Gustavomurta/EPM7032_CPLD/Images/IMG_20251213_151516328.jpg

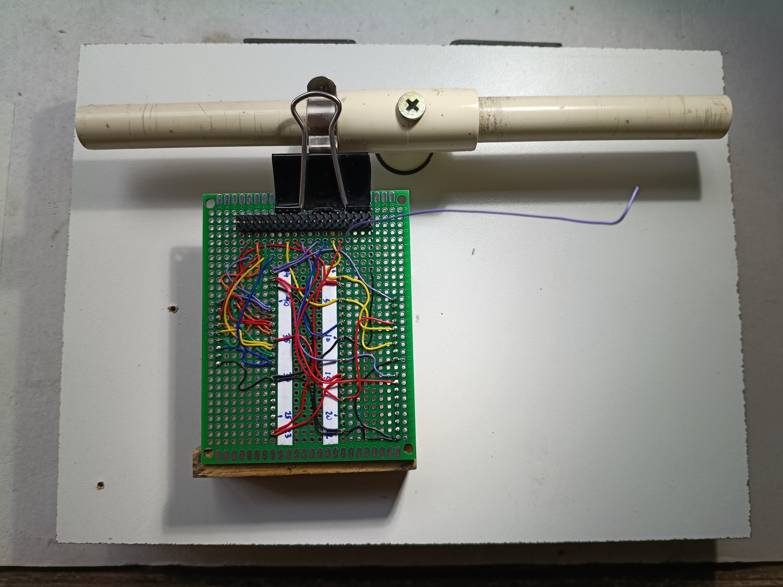
Images/IMG_20251213_151516328.jpg
