Gustavomurta/EPM7032_CPLD/Images/IMG_20251213_151541355.jpg

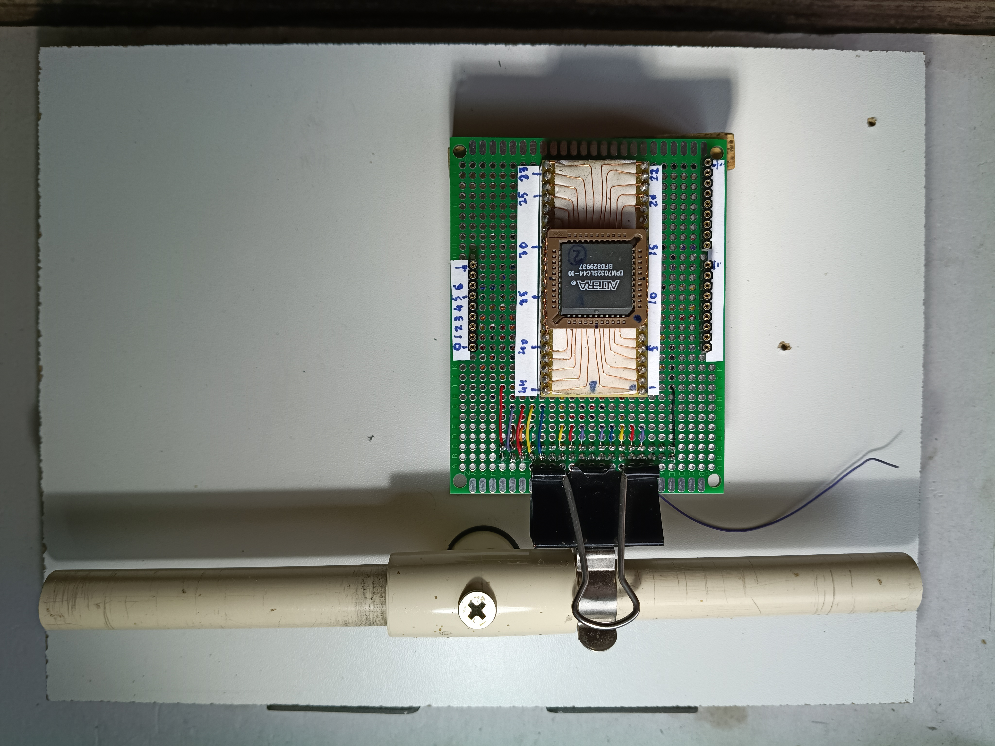
Images/IMG_20251213_151541355.jpg
