Gustavomurta/EPM7032_CPLD/hardware/EPM7032S ISP PROGRAMMER Gustavo .JPG

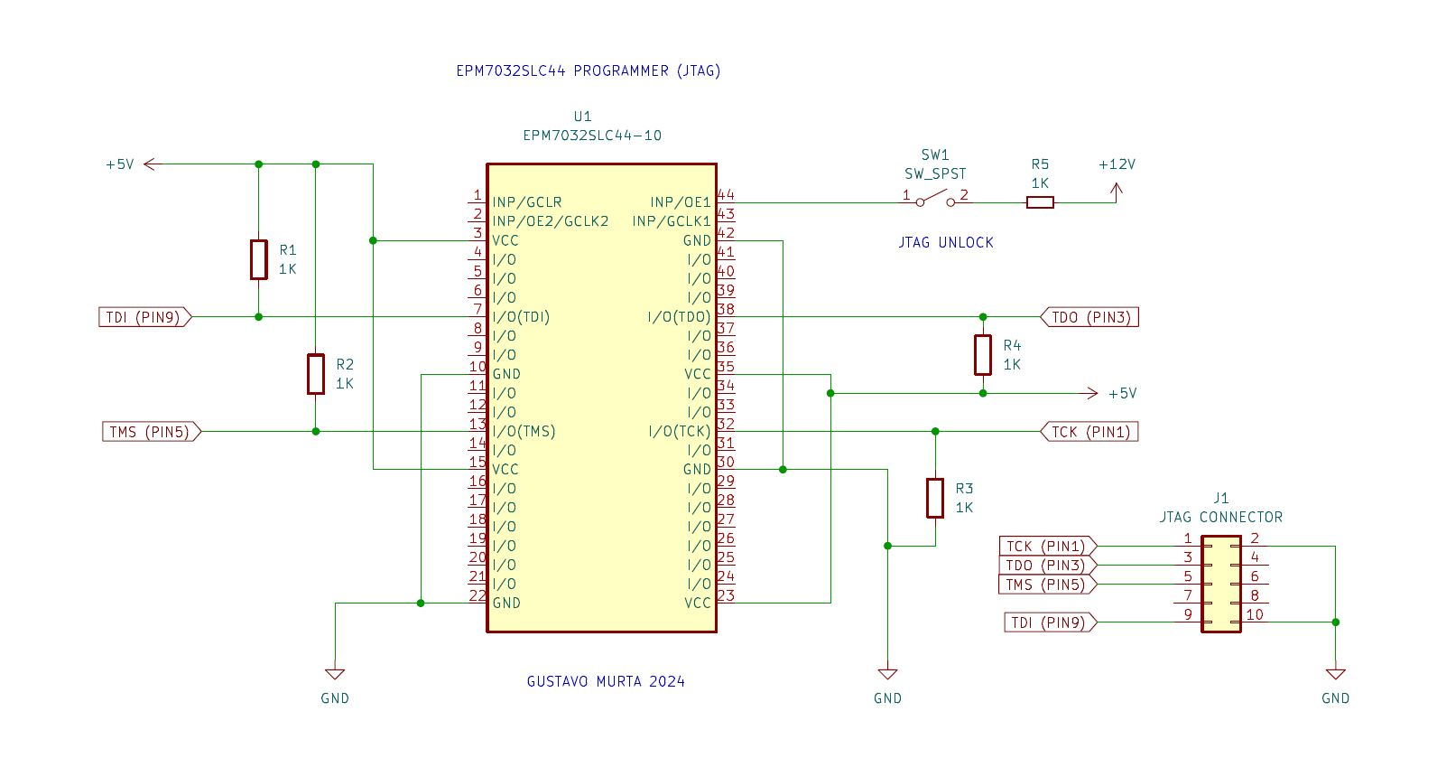
hardware/EPM7032S ISP PROGRAMMER Gustavo .JPG
