Gustavomurta/EPM7032_CPLD/hardware/EPM7032S PARALLEL PROGRAMMER GUSTAVO 2025.JPG

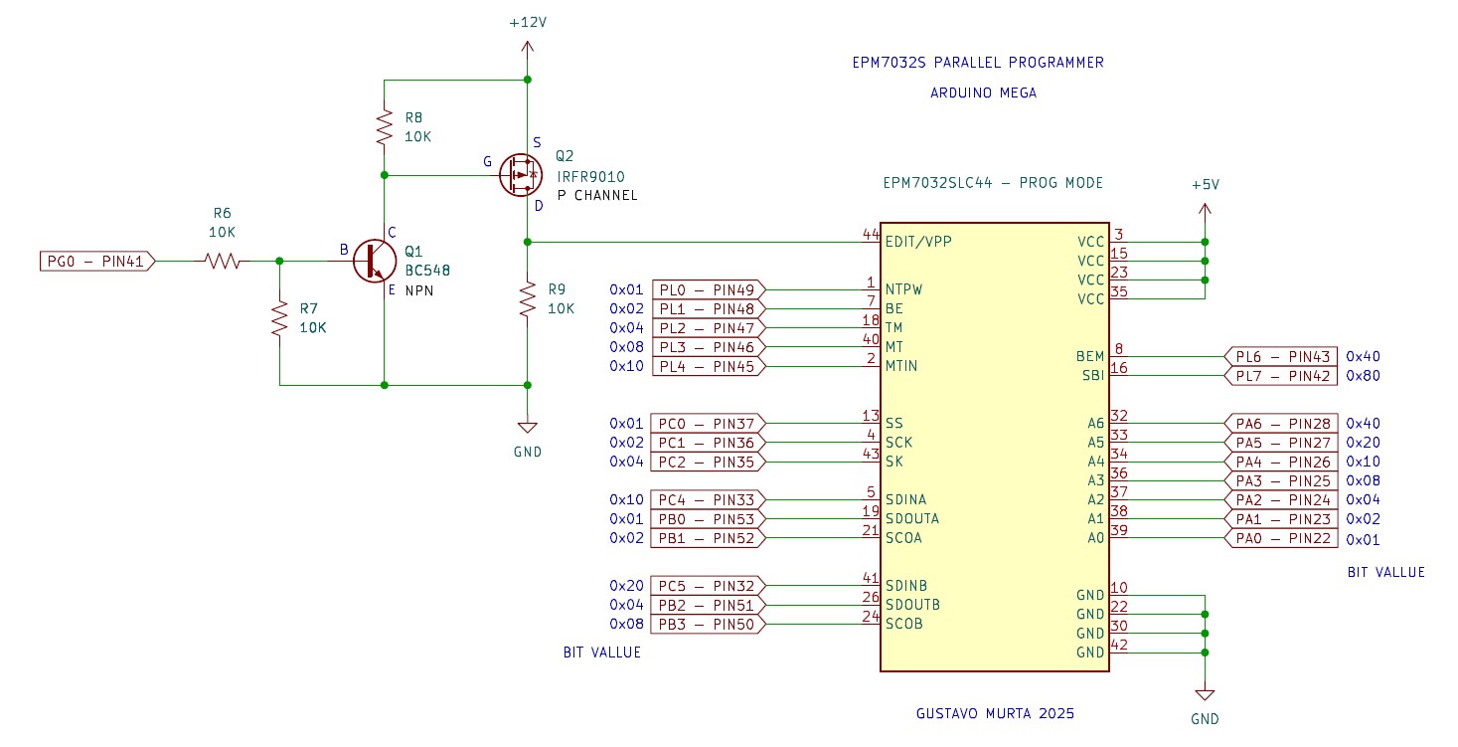
hardware/EPM7032S PARALLEL PROGRAMMER GUSTAVO 2025.JPG
