Gustavomurta/EPM7032_CPLD/Images/IMG_20251221_215948099.jpg

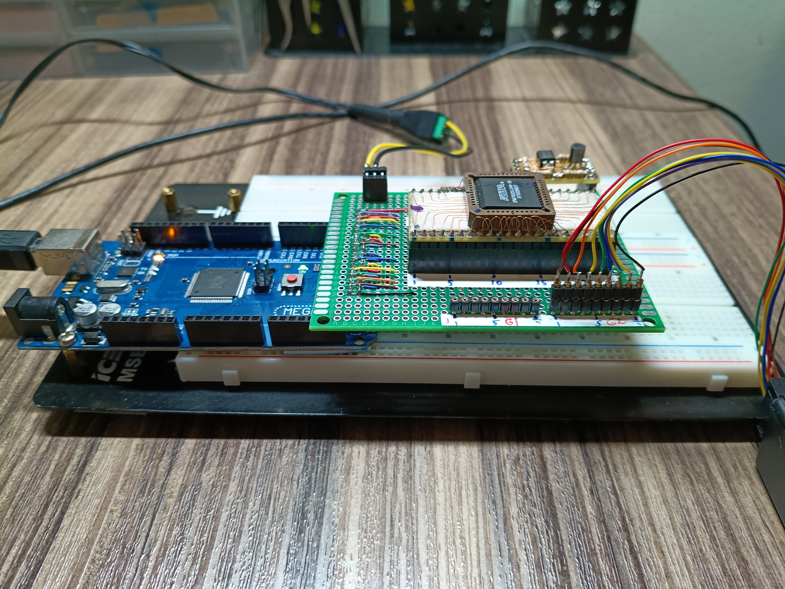
Images/IMG_20251221_215948099.jpg
