Gustavomurta/EPM7032_CPLD/hardware/EPM7032S_prog 2025.pdf

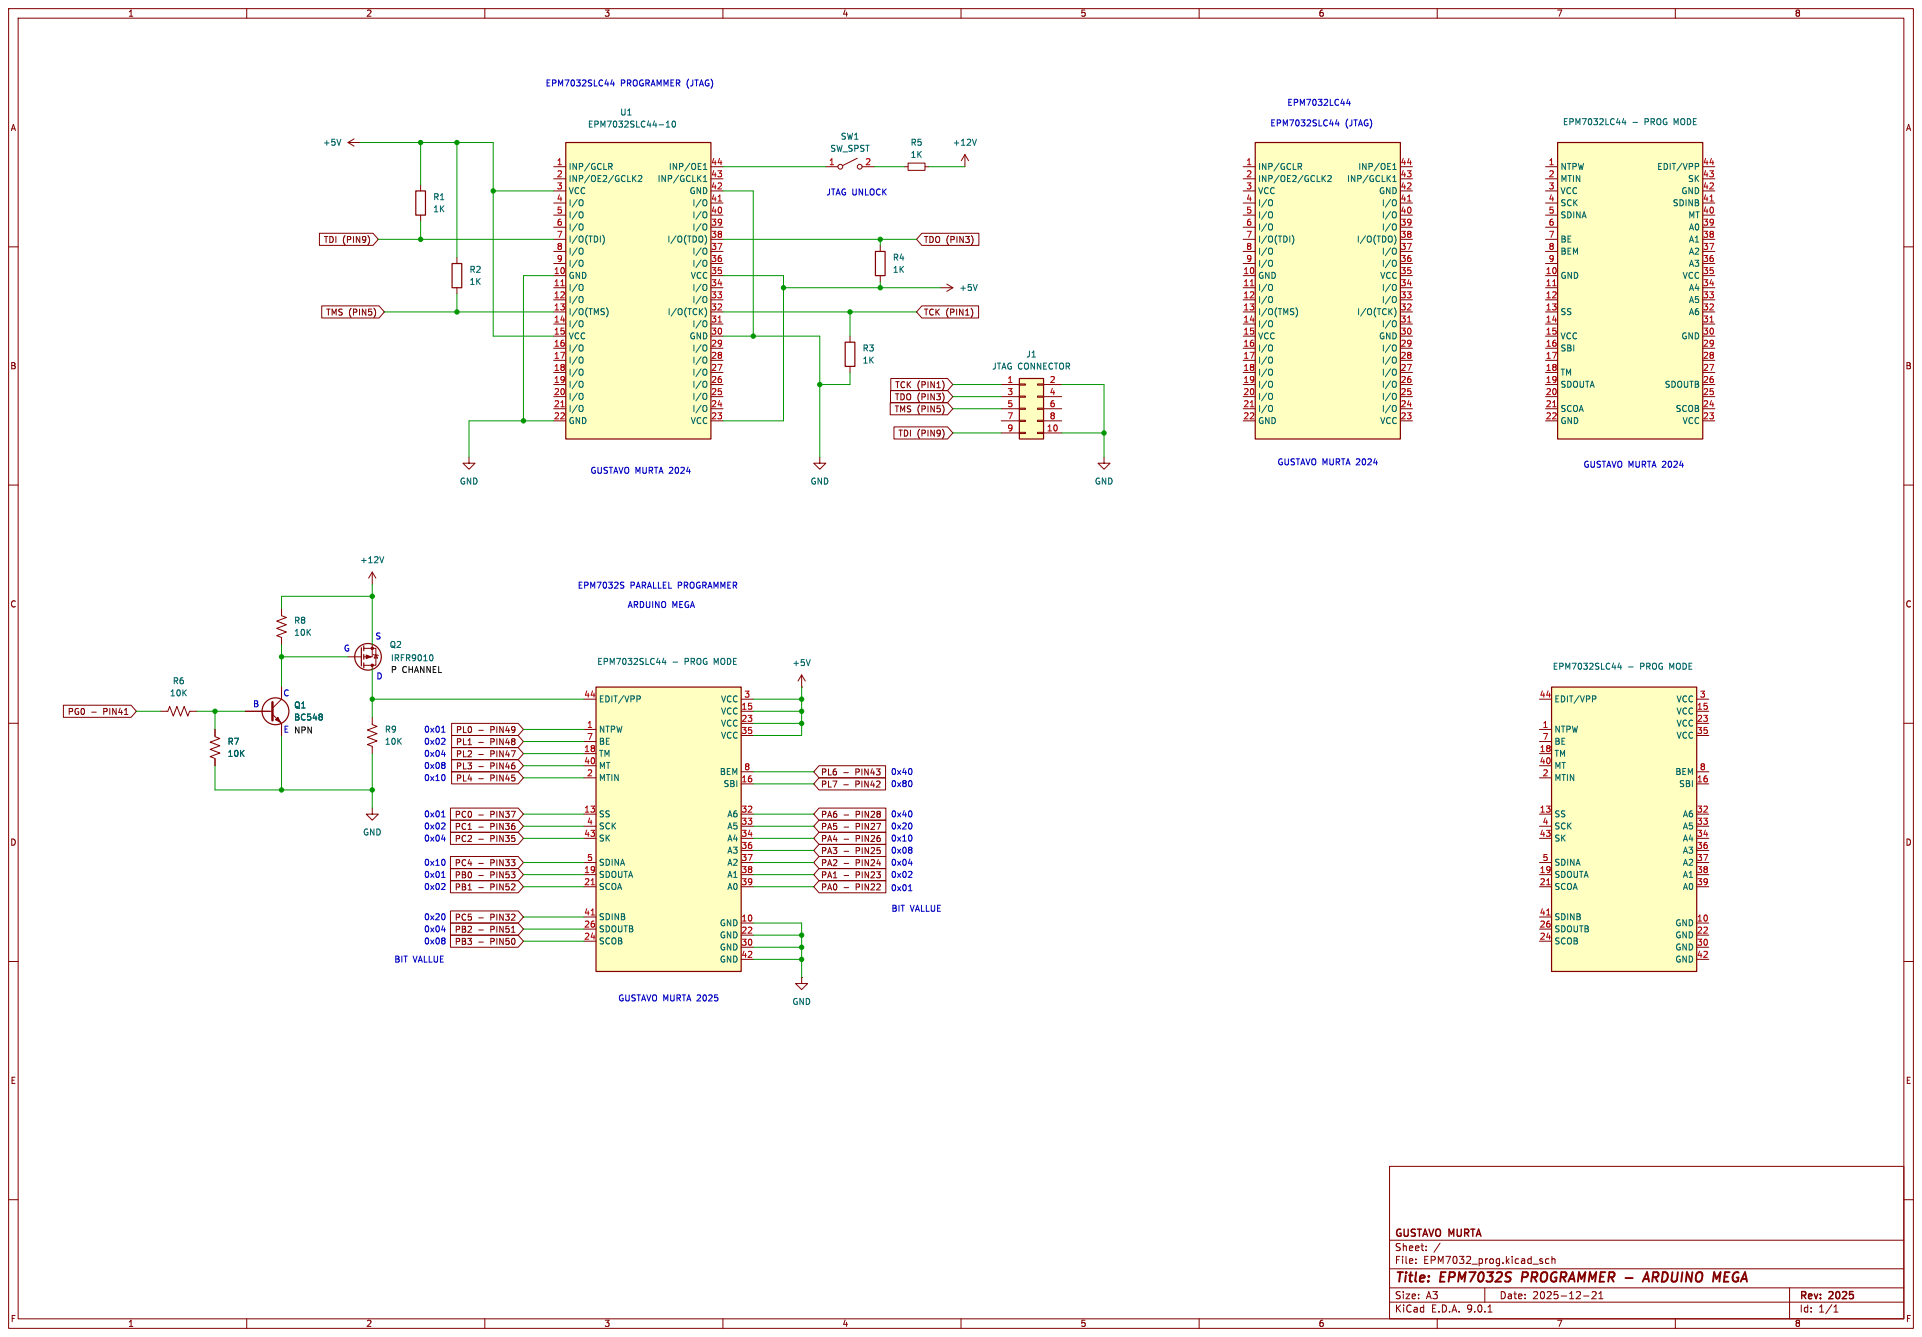
[picture p6: page 1]

NTPW 1 MTIN 2 VCC 3 SCK 4 SDINA 5

Id: 1/1 Title: EPM7032S PROGRAMMER - ARDUINO MEGA
