Gustavomurta/EPM7032_CPLD/Arduino_Mega/Arduino Mega.pdf

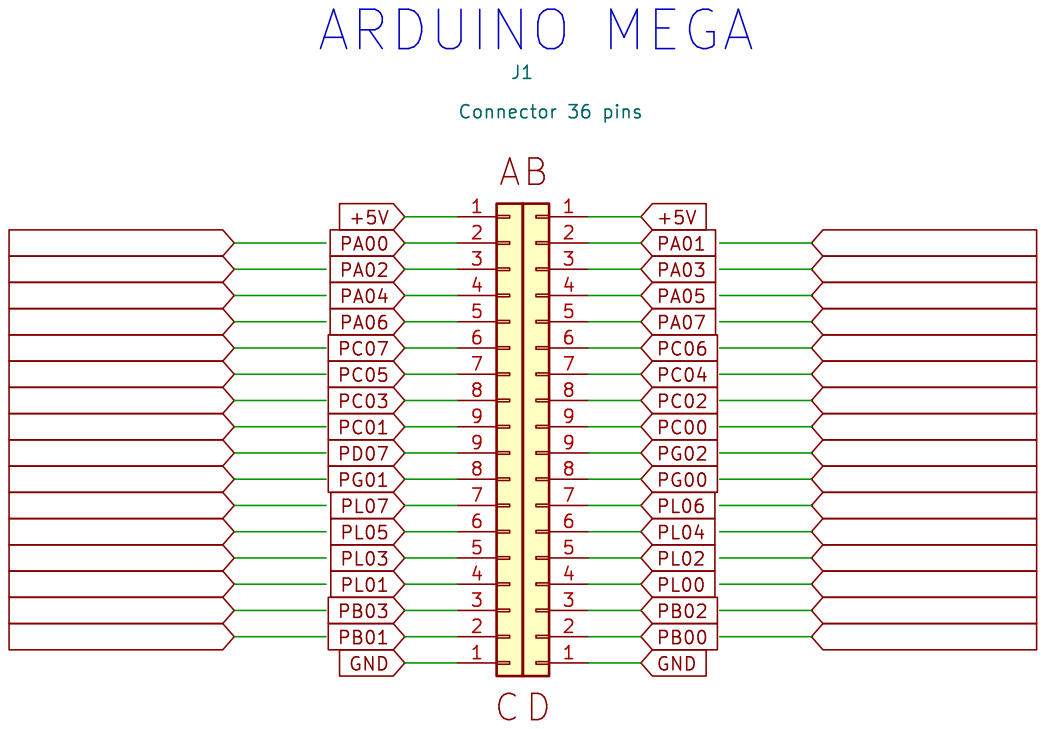
[picture p7: page 1]

Id: 1/1 Title: Arduino Mega - Connector 36 pins
