Gustavomurta/EPM7032_CPLD/(commit log)

2025-12-22 Improve formatting in arduino.md
    Reformatted text for clarity and readability.
2026-01-16 Add log for EPM7032S JTAG unlock and programming
    Documented the process of erasing and programming the EPM7032S chip using an Arduino Mega and Quartus.
